GabyTRH/Logic-Design-Magic-Box/README.md

# Logic-Design-Magic-Box
An LED-Switch box that is designed to fool the user through its underlying operations 

555-Timer LaTex: https://www.overleaf.com/project/68217dd54d0d0618d976fea1
