GabyTRH/Logic-Design-Magic-Box/prints/Main Lid.STL

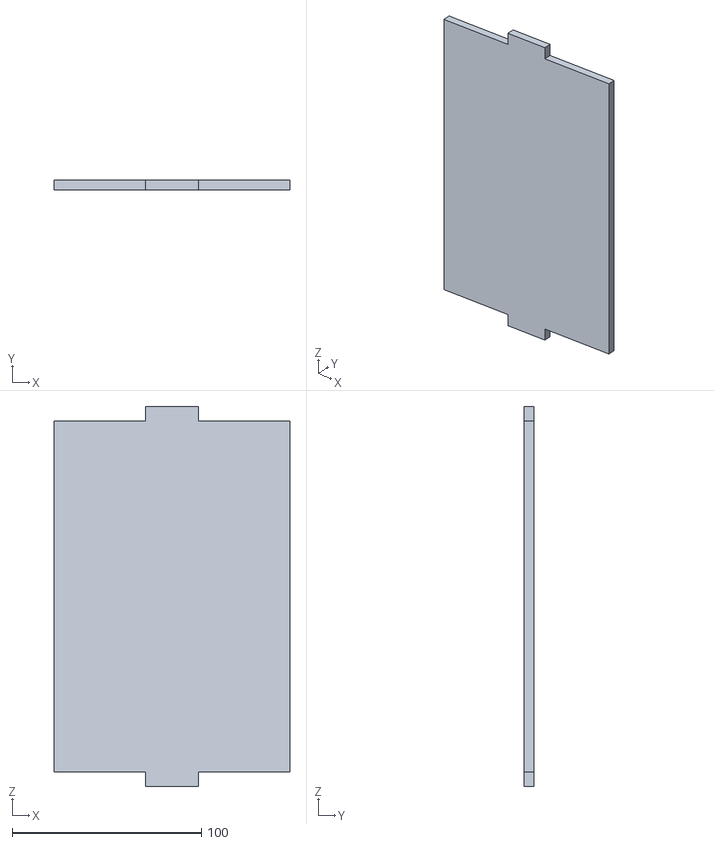
[picture p18: CAD file, 2025-05-12]
prints/Main Lid.STL
124.5 x 5.08 x 200.7
