GabyTRH/Logic-Design-Magic-Box/prints/Main box.STL

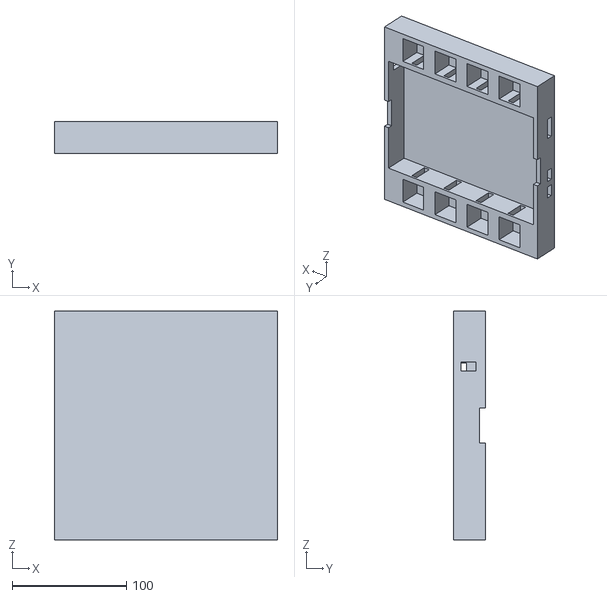
[picture p19: CAD file, 2025-05-11]
prints/Main box.STL
195.6 x 27.9 x 200.7
