GabyTRH/Logic-Design-Magic-Box/prints/Battery holder.STL

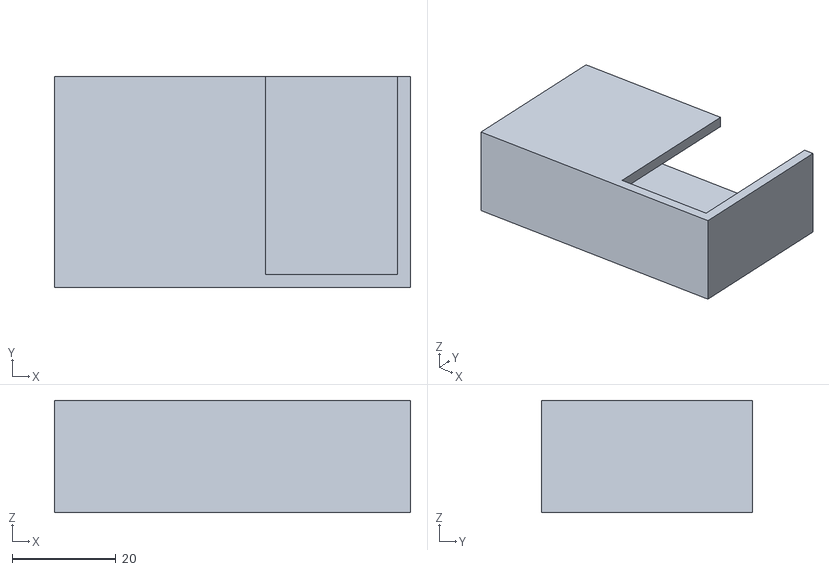
[picture p20: CAD file, 2025-05-12]
prints/Battery holder.STL
68.6 x 40.6 x 21.6
