GabyTRH/Logic-Design-Magic-Box/prints/switch box new.STL

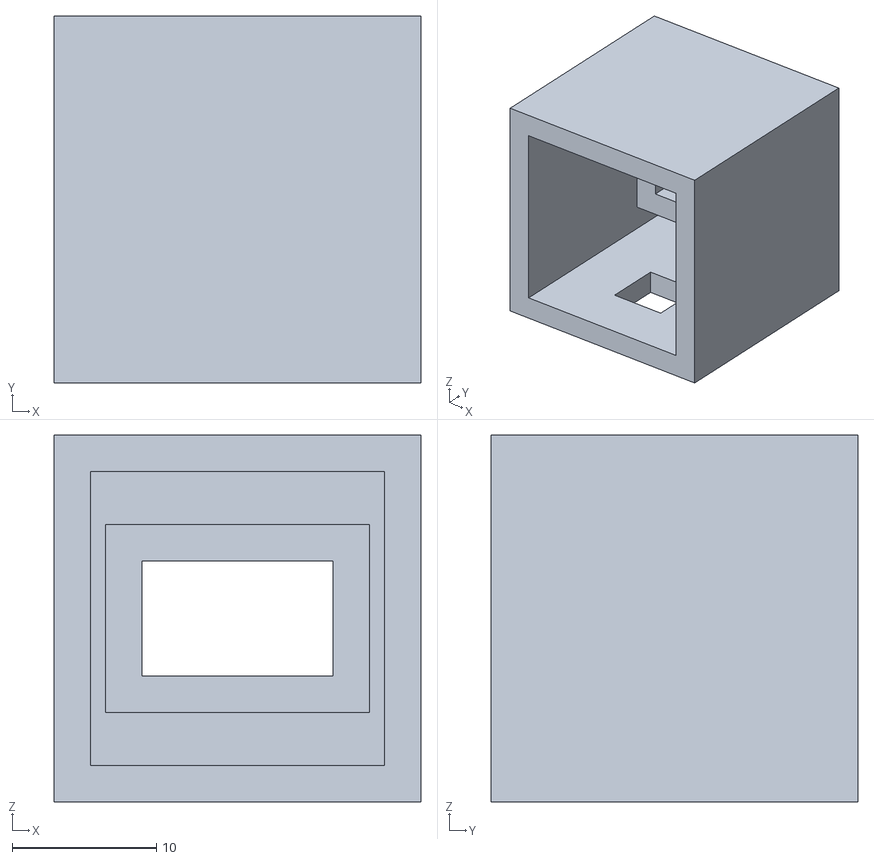
[picture p21: CAD file, 2025-05-11]
prints/switch box new.STL
25.4 x 25.4 x 25.4
