GabyTRH/Logic-Design-Magic-Box/prints/SortBox.STL

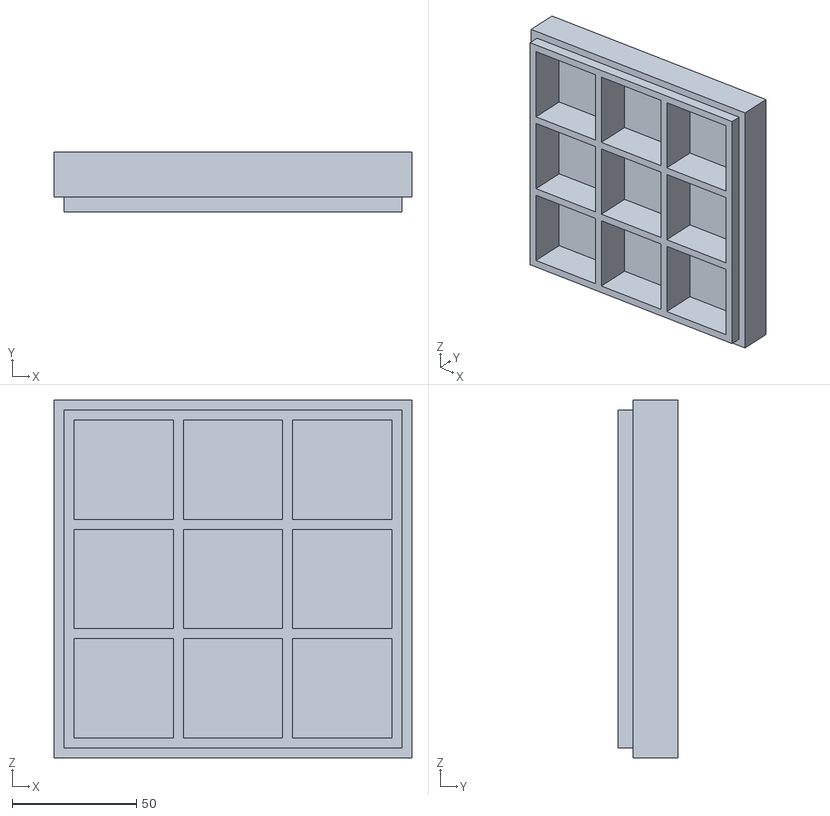
[picture p22: CAD file, 2025-05-11]
prints/SortBox.STL
144.0 x 24.0 x 144.0
