GabyTRH/Logic-Design-Magic-Box/prints/big segment lid.STL

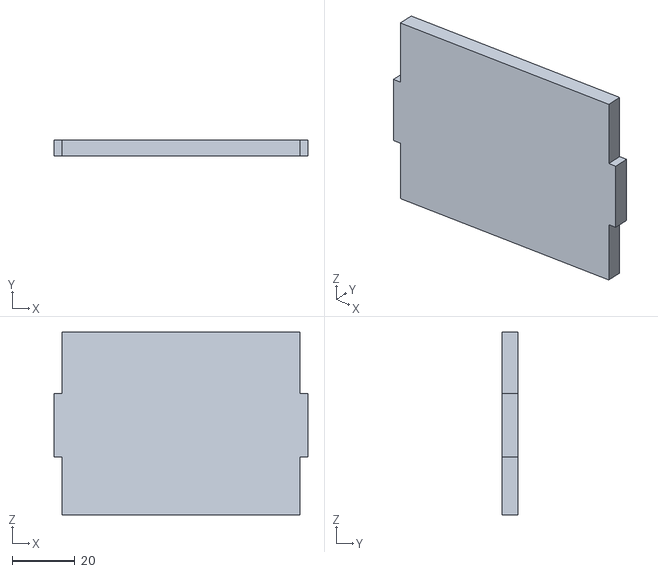
[picture p23: CAD file, 2025-05-11]
prints/big segment lid.STL
81.3 x 5.08 x 58.4
