GabyTRH/Logic-Design-Magic-Box/prints/seven lid 2.STL

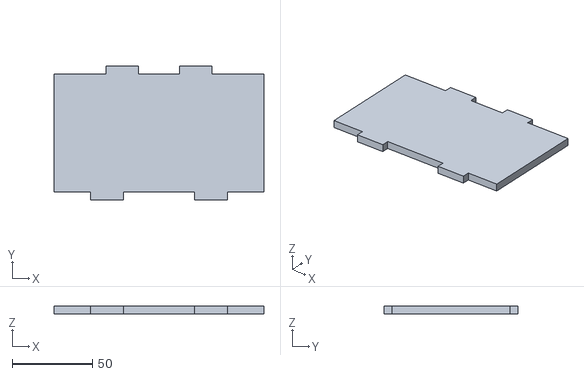
[picture p24: CAD file, 2025-05-11]
prints/seven lid 2.STL
130.8 x 83.5 x 5.08
