GabyTRH/Logic-Design-Magic-Box/prints/big segment box.STL

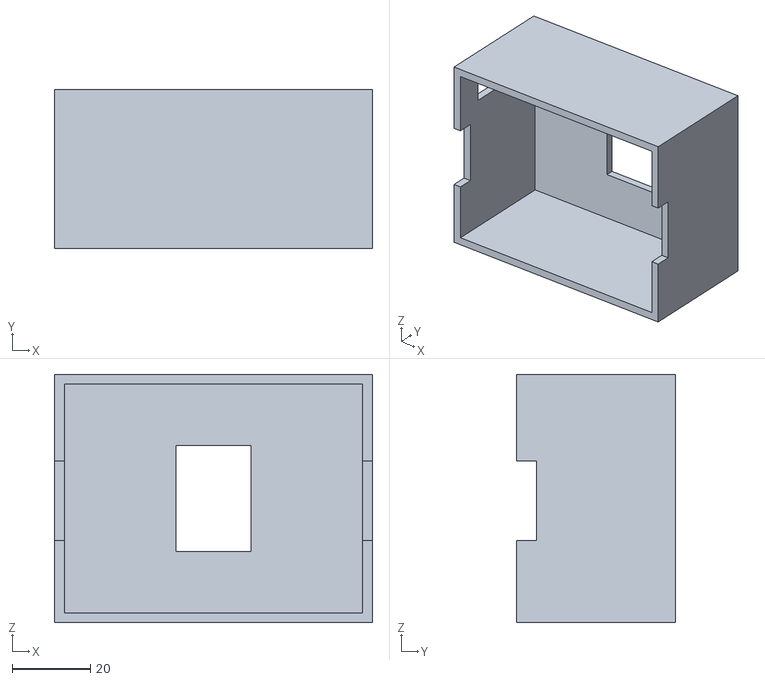
[picture p25: CAD file, 2025-05-11]
prints/big segment box.STL
81.3 x 40.6 x 63.5
