GabyTRH/Logic-Design-Magic-Box/prints/LED box new.STL

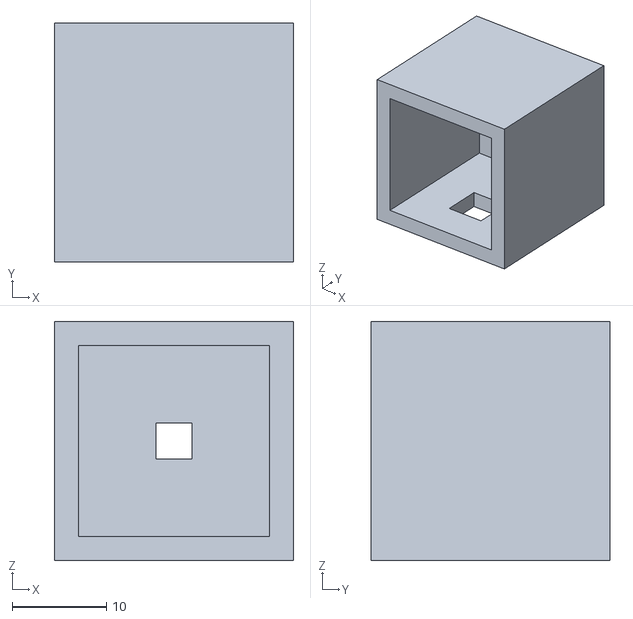
[picture p26: CAD file, 2025-05-11]
prints/LED box new.STL
25.4 x 25.4 x 25.4
