GabyTRH/Logic-Design-Magic-Box/prints/SevenBox.STL

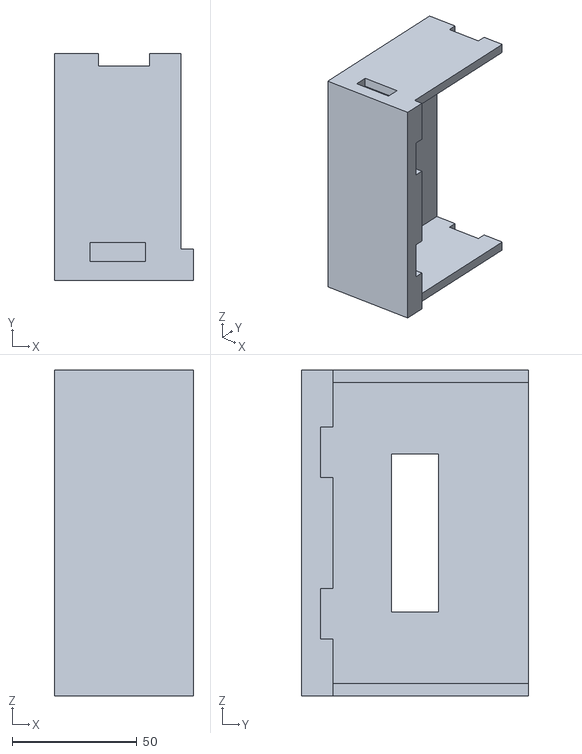
[picture p27: CAD file, 2025-05-11]
prints/SevenBox.STL
55.9 x 91.1 x 130.8
