GabyTRH/Logic-Design-Magic-Box/prints/seven Lid 1.STL

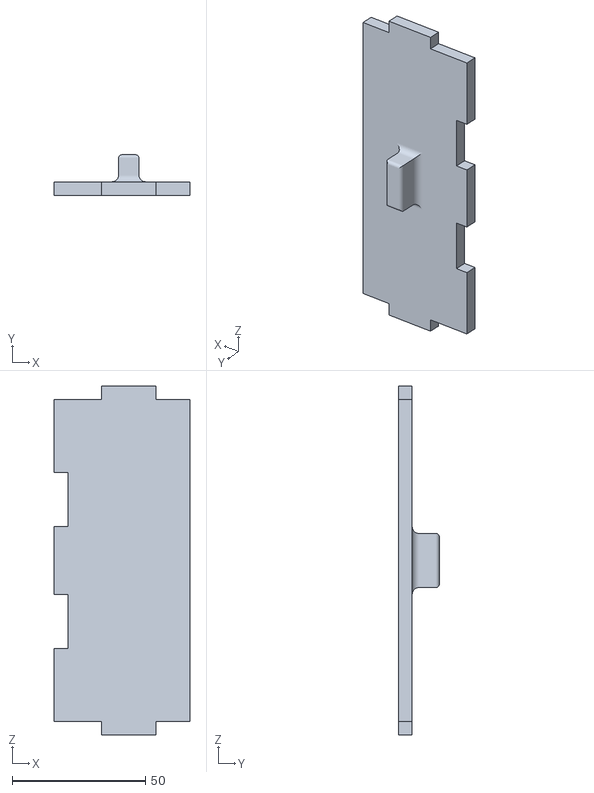
[picture p28: CAD file, 2025-05-11]
prints/seven Lid 1.STL
50.8 x 15.2 x 130.8
