GabyTRH/Logic-Design-Magic-Box/prints/SortLid.STL

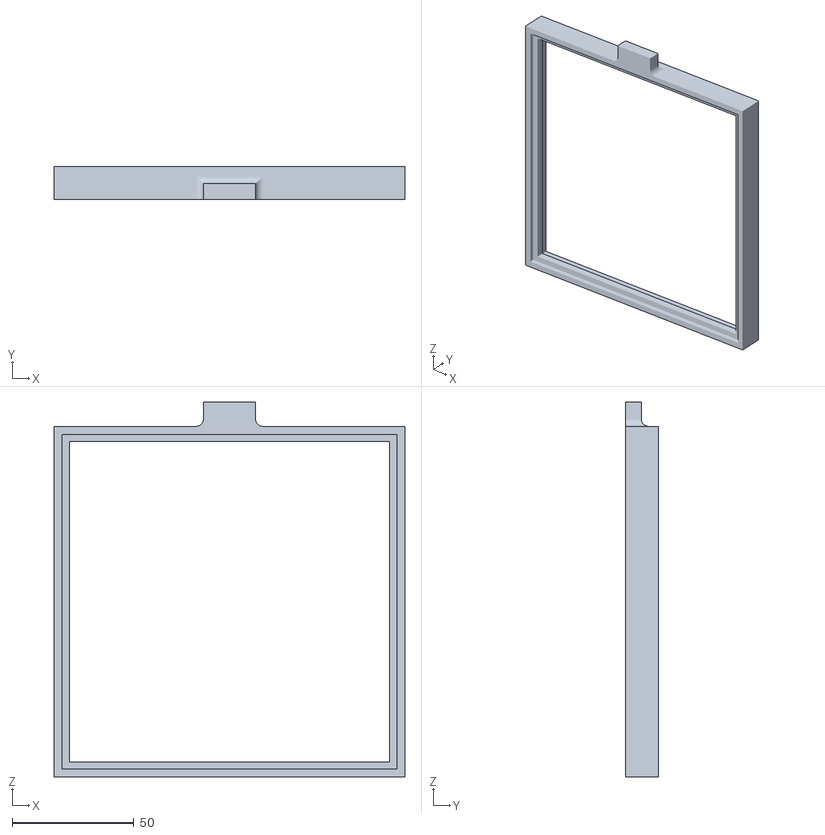
[picture p29: CAD file, 2025-05-11]
prints/SortLid.STL
144.0 x 13.5 x 154.0
