GabyTRH/Logic-Design-Magic-Box/(list of files, cad)

Other CAD files:
prints/switch box.STL
prints/LED box.STL
