GabyTRH/Logic-Design-Magic-Box/(commit log)

2025-05-11 Completed Switch State Module Need Quartus
    [LED box new.STL, LED box.STL, Main Lid.STL, Main box.STL, SevenBox.STL, SortBox.STL, SortLid.STL, big segment box.STL]
2025-05-12 Added State Diagram and multiplexing solution with 555 Timer LaTex Link
    [Main Lid.STL]
2025-05-12 added special trick documentation
    [Battery holder.STL]
